ThomasJagielski/MADVLSI-MP2/images/layout_images/shift_register_layout_width_2.png

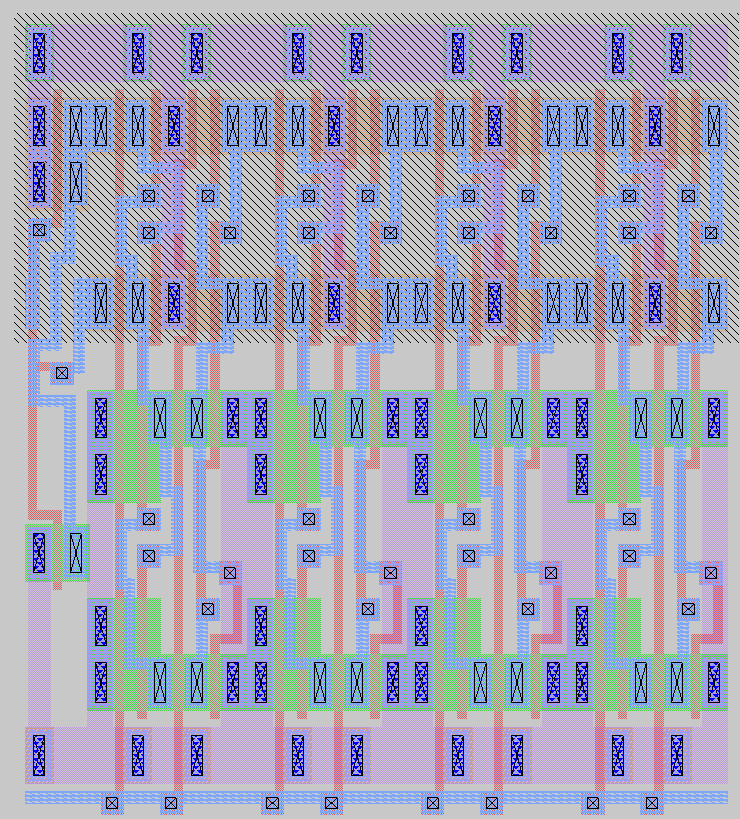
images/layout_images/shift_register_layout_width_2.png
