ThomasJagielski/MADVLSI-MP2/images/schematic_images/latch_schematic_width_1.png

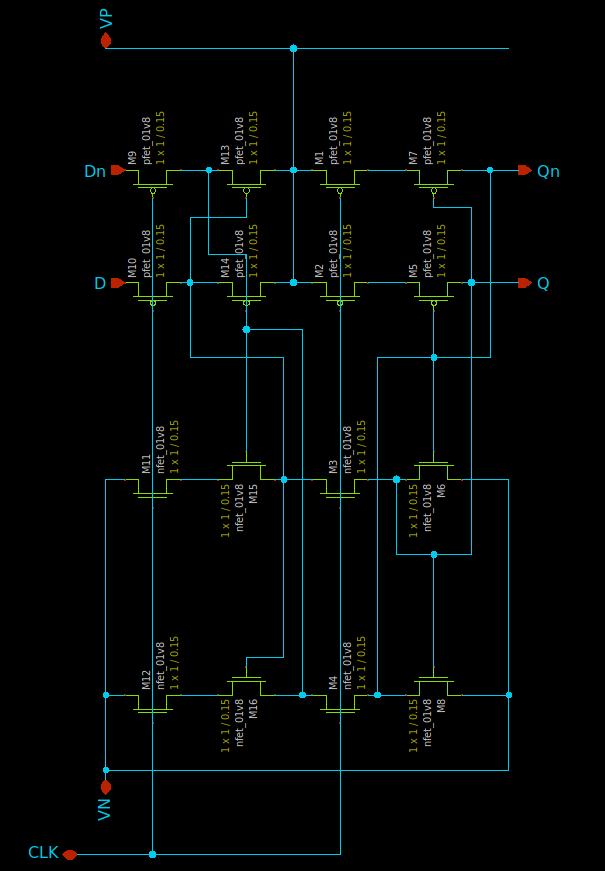
images/schematic_images/latch_schematic_width_1.png
