ThomasJagielski/MADVLSI-MP2/(commit log)

2021-02-21 Add schematics
    [CSRL.sch, CSRL_simulate (another copy).sch, CSRL_simulate (copy).sch, CSRL_simulate.sch, CSRL_tall.sch, inverter.sch]
2021-02-23 Add shift register and symbol
    [CSRL.sch, CSRL_D_FF.sch, CSRL_simulate (3rd copy).sch, CSRL_simulate (another copy).sch, CSRL_simulate (copy).sch, CSRL_simulate.sch, CSRL_tall.sch, shift_register_simulation.sch]
2021-02-23 Add images of schematics
2021-02-25 Add new netlists
    [CSRL_D_FF.sch, CSRL_D_FF_LVS.sch]
2021-02-25 Add shift register and LVS
    [shift_register_lvs.sch]
2021-02-27 Add width 1 layout and simulation
    [CSRL_D_FF_w_1.sch, CSRL_D_FF_w_1_LVS.sch, inverter.sch, shift_register_w_1_lvs.sch, shift_register_w_1_simulation.sch]
2021-02-28 Add updated LVS
    [shift_register_lvs.sch]
2021-03-01 Add inverter to layout
    [CSRL_D_FF.sch, CSRL_D_FF_LVS.sch, inverter.sch, shift_register_lvs.sch, shift_register_simulation.sch, shift_register_w_1_lvs.sch]
2021-03-02 Add updates
    [shift_register_simulation.sch, shift_register_w_1_simulation.sch]
2021-03-02 Add final versions of layout and schematic
    [CSRL_D_FF.sch, CSRL_D_FF_LVS.sch, inverter.sch, shift_register_lvs.sch, shift_register_simulation.sch]
